ndbroadbent/esp32c3-doom-bauble/case/bottom_plate.stl

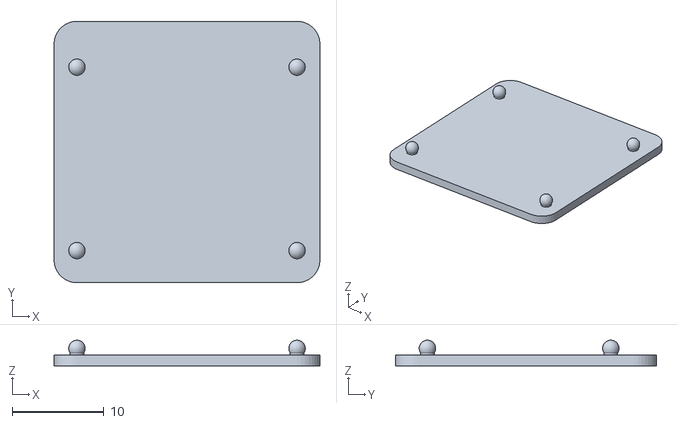
[picture p1: CAD file, 2022-12-12]
case/bottom_plate.stl
29.0 x 28.5 x 2.80
