ndbroadbent/esp32c3-doom-bauble/pcb/bauble_pcb.kicad_pcb

## KiCad design pcb/bauble_pcb.kicad_pcb (2022-12-10)

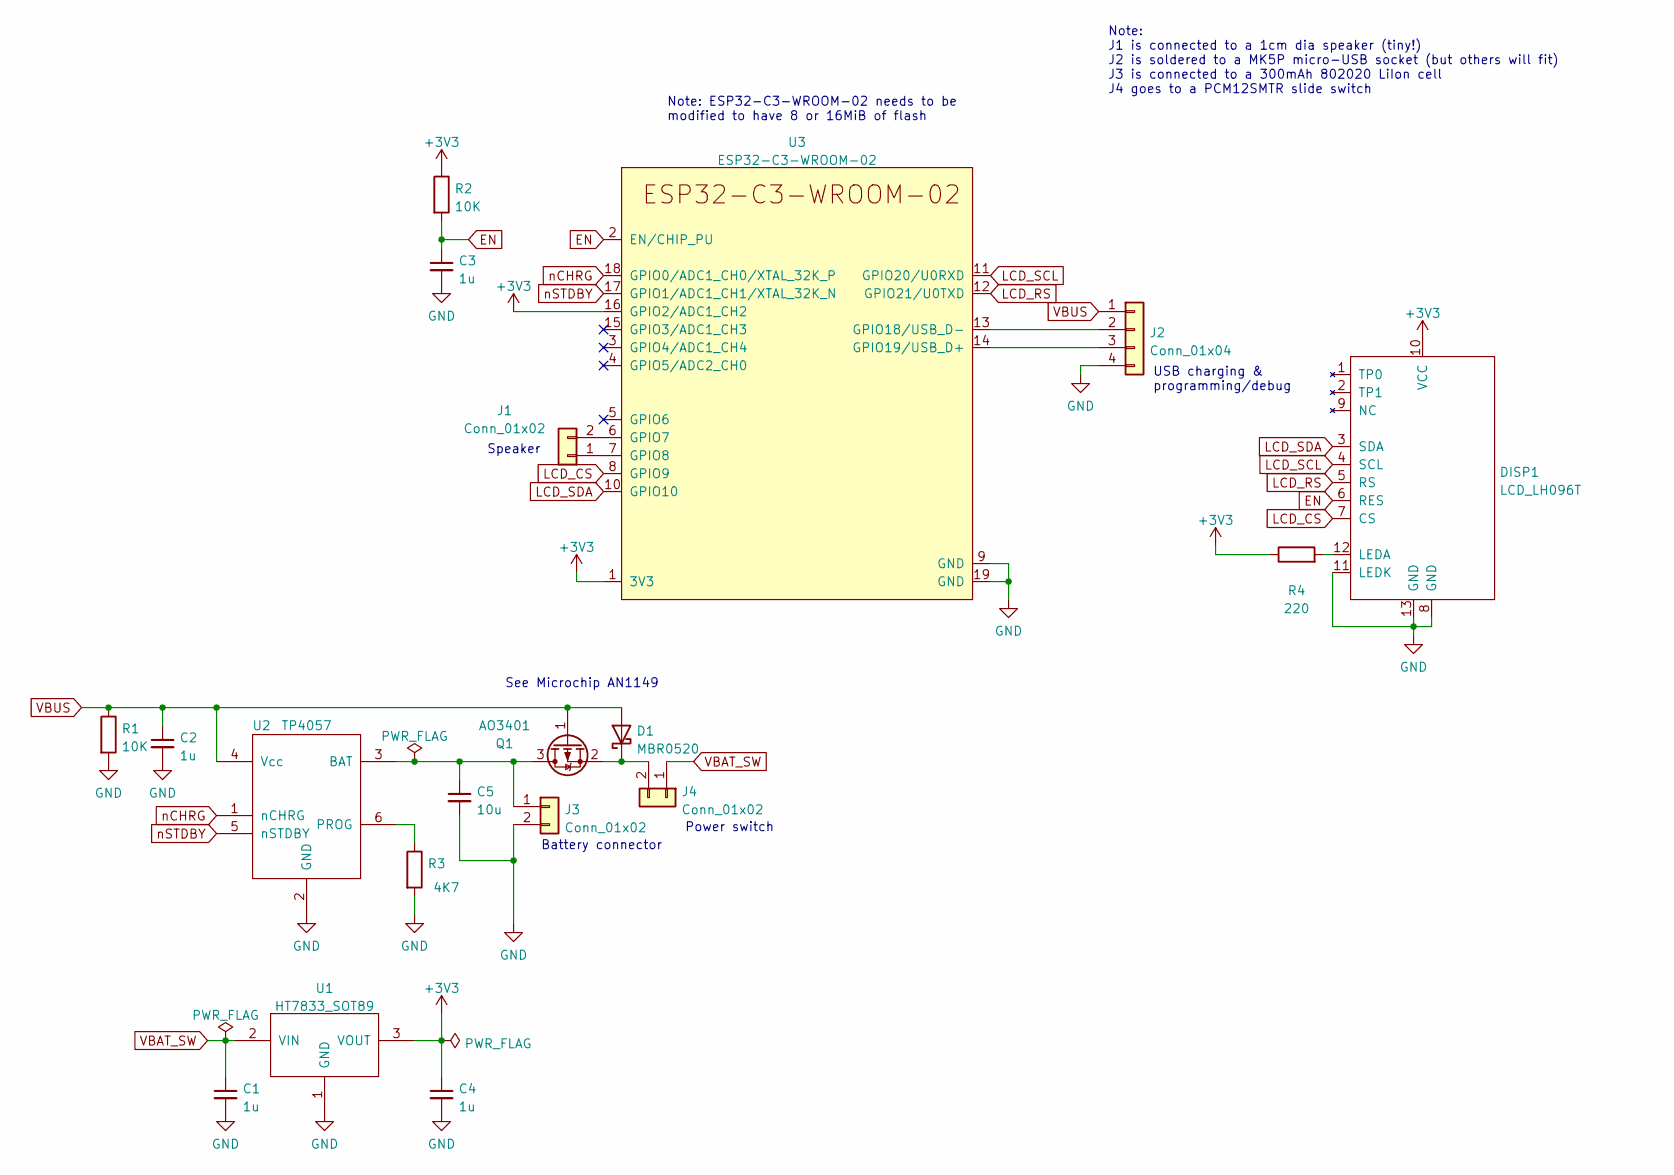
[picture p2: schematic bauble_pcb.kicad_sch]

Parts:
C1, C2, C3, C4: 1u; C_0603_1608Metric
C5: 10u; C_0805_2012Metric
D1: MBR0520; D_SOD-123
DISP1: LCD_LH096T; LCD_LH086T
J1, J3, J4: Conn_01x02; PinHeader_1x02_P1.27mm_Vertical
J2: Conn_01x04; PinHeader_1x04_P1.27mm_Vertical
Q1: AO3401; SOT-23
R1, R2: 10K; R_0603_1608Metric
R3: 4K7; R_0603_1608Metric
R4: 220; R_0603_1608Metric
U1: HT7833_SOT89; SOT-89-3
U2: TP4057; SOT-23-6
U3: ESP32-C3-WROOM-02

Connections:
+3V3: C4.1, DISP1.10 (VCC), R2.1, R4.1, U1.3 (VOUT), U3.1 (3V3), U3.16 (GPIO2/ADC1_CH2)
EN: C3.1, DISP1.6 (RES), R2.2, U3.2 (EN/CHIP_PU)
GND: C1.2, C2.2, C3.2, C4.2, C5.2, DISP1.8 (GND), DISP1.11 (LEDK), DISP1.13 (GND), J2.4, J3.2, R1.2, R3.2, U1.1 (GND), U2.2 (GND), U3.9 (GND), U3.19 (GND)
LCD_CS: DISP1.7 (CS), U3.8 (GPIO9)
LCD_RS: DISP1.5 (RS), U3.12 (GPIO21/U0TXD)
LCD_SCL: DISP1.4 (SCL), U3.11 (GPIO20/U0RXD)
LCD_SDA: DISP1.3 (SDA), U3.10 (GPIO10)
unnamed: C5.1, J3.1, Q1.3 (D), U2.3 (BAT)
unnamed: D1.1 (K), J4.2, Q1.2 (S)
unnamed: DISP1.12 (LEDA), R4.2
unnamed: J2.2, U3.13 (GPIO18/USB_D-)
unnamed: J2.3, U3.14 (GPIO19/USB_D+)
unnamed: R3.1, U2.6 (PROG)
unnamed: J1.2, U3.6 (GPIO7)
unnamed: J1.1, U3.7 (GPIO8)
VBAT_SW: C1.1, J4.1, U1.2 (VIN)
VBUS: C2.1, D1.2 (A), J2.1, Q1.1 (G), R1.1, U2.4 (Vcc)
nCHRG: U2.1 (nCHRG), U3.18 (GPIO0/ADC1_CH0/XTAL_32K_P)
nSTDBY: U2.5 (nSTDBY), U3.17 (GPIO1/ADC1_CH1/XTAL_32K_N)

Notes on the sheet:
See Microchip AN1149
Battery connector
Speaker
Note: ESP32-C3-WROOM-02 needs to be modified to have 8 or 16MiB of flash
Power switch
USB charging & programming/debug
Note: J1 is connected to a 1cm dia speaker (tiny!) J2 is soldered to a MK5P micro-USB socket (but others will fit) J3 is connected to a 300mAh 802020 LiIon cell J4 goes to a PCM12SMTR slide switch

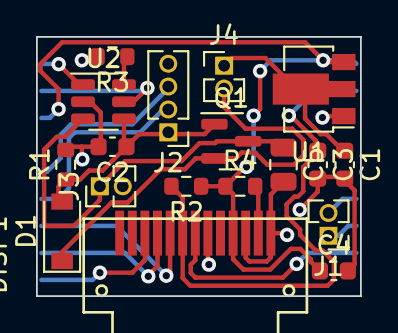
[picture p3: board bauble_pcb.kicad_pcb from above]

Board: 2 copper layers, 18.0 x 14.4 mm, 19 parts (1 on the bottom side), 19 nets.
