ndbroadbent/esp32c3-doom-bauble/(commit log)

2022-12-10 remove pcb/fp-info-cache
2022-12-10 Exclude ESP32, connectors, LCD from BOM and POS
    [bauble_pcb.kicad_pcb]
2022-12-10 Exclude connectors in schematic from BOM
    [bauble_pcb.kicad_sch]
2022-12-10 Update gerber files, BOM, placement
    [bauble_pcb-B_Cu.gbr, bauble_pcb-B_Mask.gbr, bauble_pcb-B_Paste.gbr, bauble_pcb-B_Silkscreen.gbr, bauble_pcb-Edge_Cuts.gbr, bauble_pcb-F_Cu.gbr, bauble_pcb-F_Mask.gbr, bauble_pcb-F_Paste.gbr]
2022-12-10 Remove LCD and ESP32 from BOM
    [bauble_pcb.csv, bauble_pcb.kicad_sch]
2022-12-12 Checked in bottom plate STL
    [bottom_plate.stl]
2022-12-12 Increase speaker grill hole size to 1.5mm
    [case.scad]
2022-12-12 Added JLCPCB files
    [pcb_bom_jlc.csv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]
2022-12-12 Increase wall width between pc and monitor, increase slot width for wires, add slot for LCD ribbon
    [case.scad]
2022-12-12 revert wall thickness change, looks better
    [case.scad]
2022-12-12 Update bottom plate
    [bottom_plate.stl]
2022-12-12 Increase thickness of bottom plate to >1mm to avoid JLC warnings
    [bottom_plate.stl, case.scad]
